zhouxy-rrookie/DOG/CAD/sefa v1.png

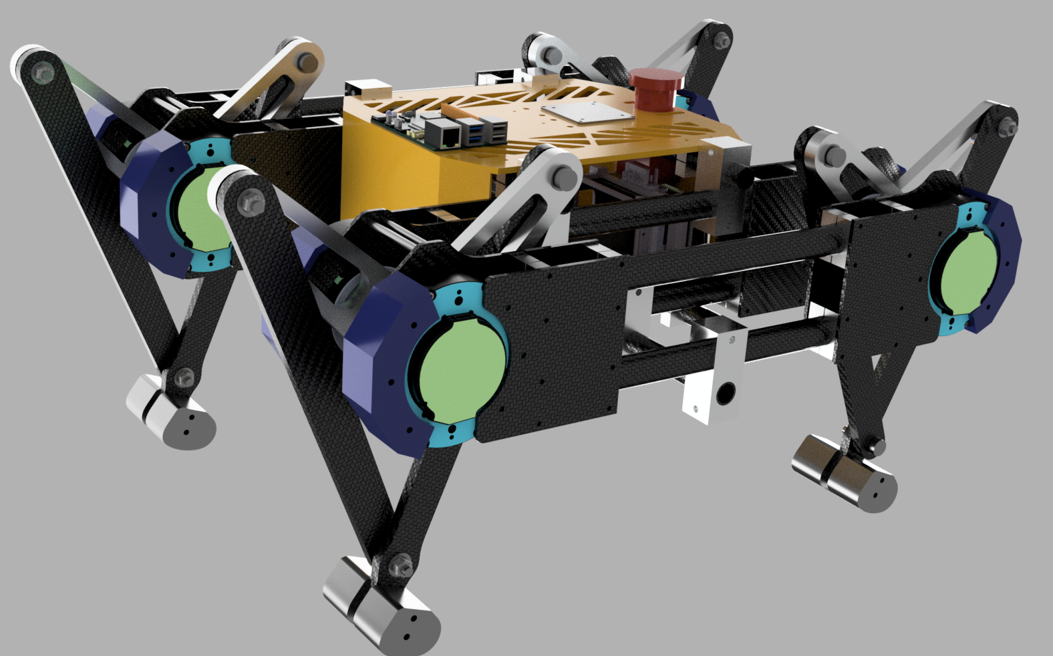
CAD/sefa v1.png
