zhouxy-rrookie/DOG/README.md

# DOG
CSU-EK Quadruped robot
VBDBE5116
