zhouxy-rrookie/DOG/readme.txt

2月19日，增加了陀螺仪和温度计的配置，cal.c开工，完成四连杆运动学正解算，正确性有待仿真考证。
