zhouxy-rrookie/DOG/doc/中南大学EK战队四足技术介绍（2026.2）.pdf

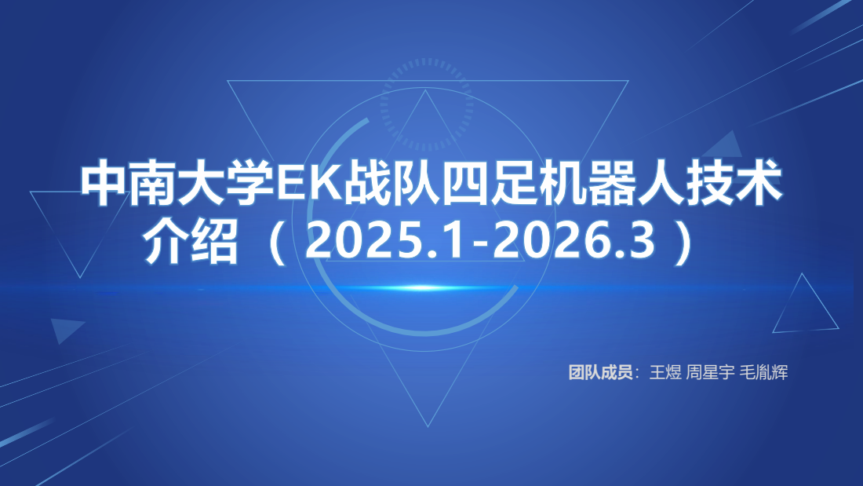
[picture p22: page 1]
中南大学EK战队四足机器人技术 介绍（ 2025.1-2026.3 ）

团队成员：王煜 周星宇 毛胤辉

# 核心竞争力

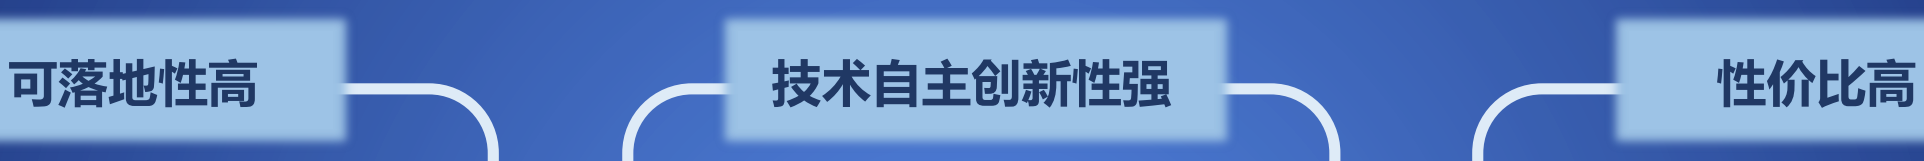
[picture p23: figure]
可落地性高; 技术自主创新性强; 性价比高
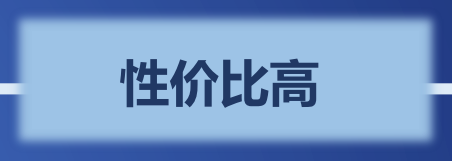
[picture p24: figure]

因产品选材、设计装配全
部流程均为有成本控制经验
的成员自主完成，相较于同
类型无人末端配送产品，本

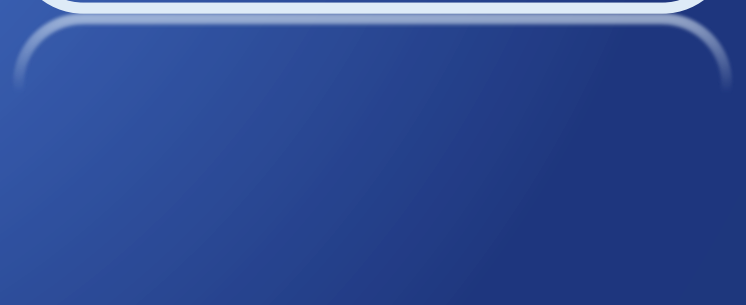
[picture p25: figure]

产品成本仅为京东无人车的
八分之一，而在复杂环境中
的执行能力更优。

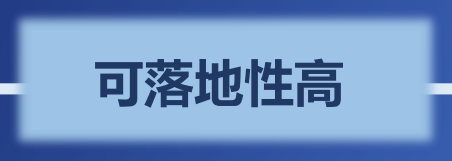
[picture p26: figure]

该项目依托中南大学工
程训练创新中心，核心成
员均来自参加大学生机器
人RoboCon竞赛的中南大

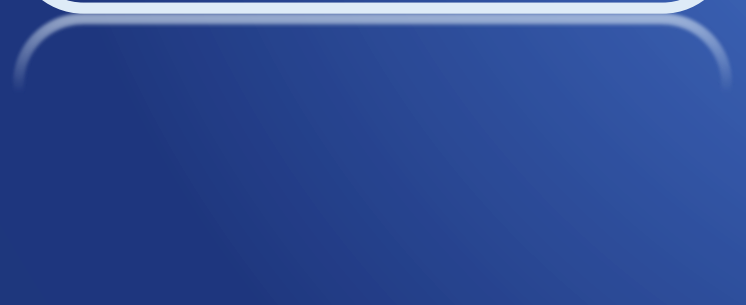
[picture p27: figure]

学EK机器人队，已做出实
物样机并在实验室测试验
证初步功能。

本项目机器狗设计制造全部
流程均由团队成员自主完成,独
立研发了动态雅可比补偿虚拟
力控算法增强运动灵活性，开

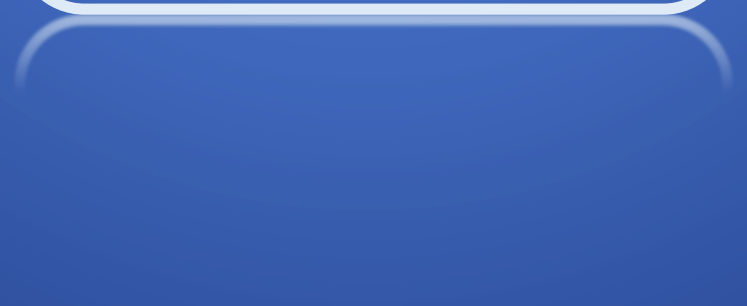
[picture p28: figure]

发行业前沿的PNLC-SLAM算
法 实 现 精 确 导 航 ， 改进 A*-
DWA算法做到高速动态避障。
项目概要 | 市场分析 | 产品介绍 | 项目成果| 未来计划

# 产品介绍

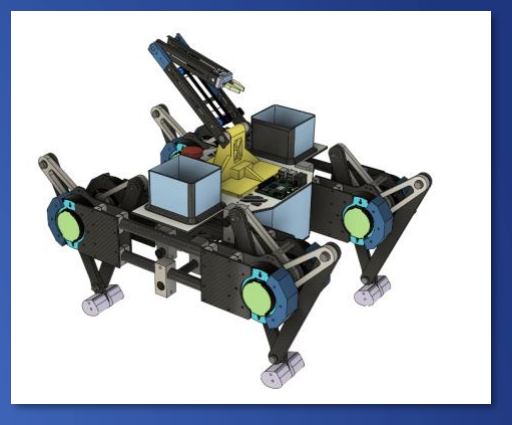
[picture p29: figure]
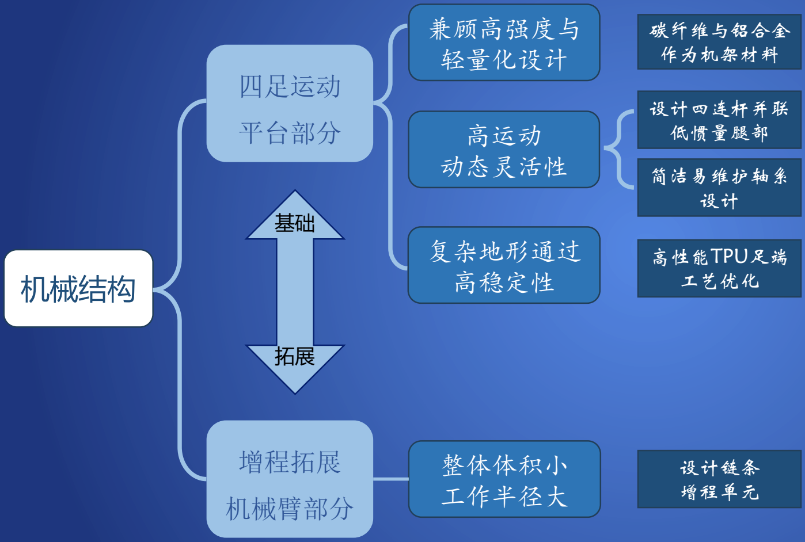
[picture p30: figure]
机械结构; 四足运动; 平台部分; 增程拓展; 机械臂部分; 兼顾高强度与 轻量化设计; 高运动 动态灵活性; 复杂地形通过 高稳定性; 整体体积小 工作半径大; 碳纤维与铝合金 作为机架材料; 设计四连杆并联 低惯量腿部; 简洁易维护轴系 设计; 高性能TPU足端 工艺优化; 设计链条 增程单元

零号机器狗示意图

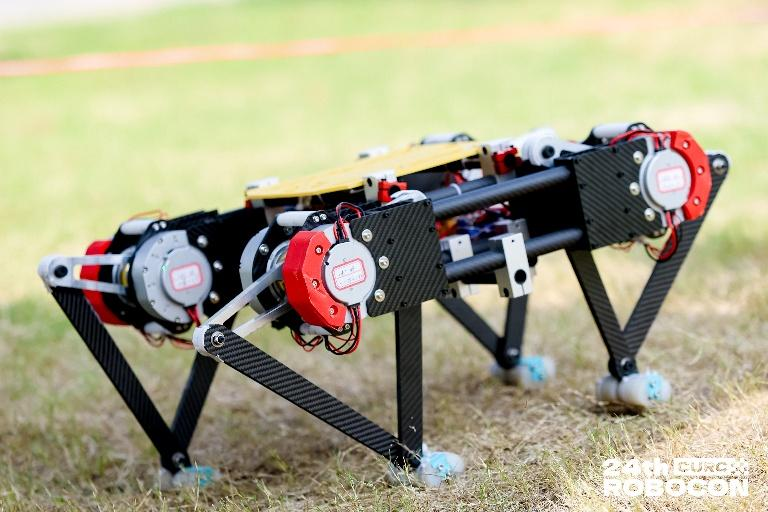
[picture p31: figure]

机器狗实物（ROBOCON越野赛）

项目概要 | 市场分析 | 产品介绍 | 项目成果| 未来计划

# 机械结构

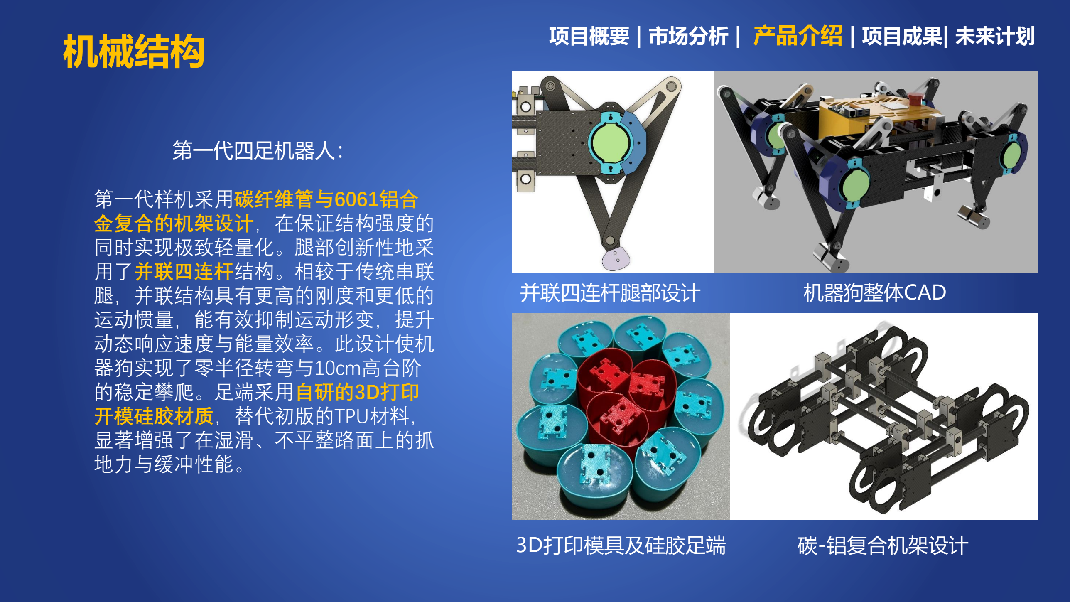
[picture p32: page 4]

第一代四足机器人：

第一代样机采用碳纤维管与6061铝合
金复合的机架设计，在保证结构强度的
同时实现极致轻量化。腿部创新性地采
用了并联四连杆结构。相较于传统串联
腿，并联结构具有更高的刚度和更低的
运动惯量，能有效抑制运动形变，提升
动态响应速度与能量效率。此设计使机
器狗实现了零半径转弯与10cm高台阶
的稳定攀爬。足端采用自研的3D打印
开模硅胶材质，替代初版的TPU材料，
显著增强了在湿滑、不平整路面上的抓
地力与缓冲性能。
3D打印模具及硅胶足端 | 碳-铝复合机架设计
并联四连杆腿部设计 | 机器狗整体CAD
项目概要 | 市场分析 | 产品介绍 | 项目成果| 未来计划

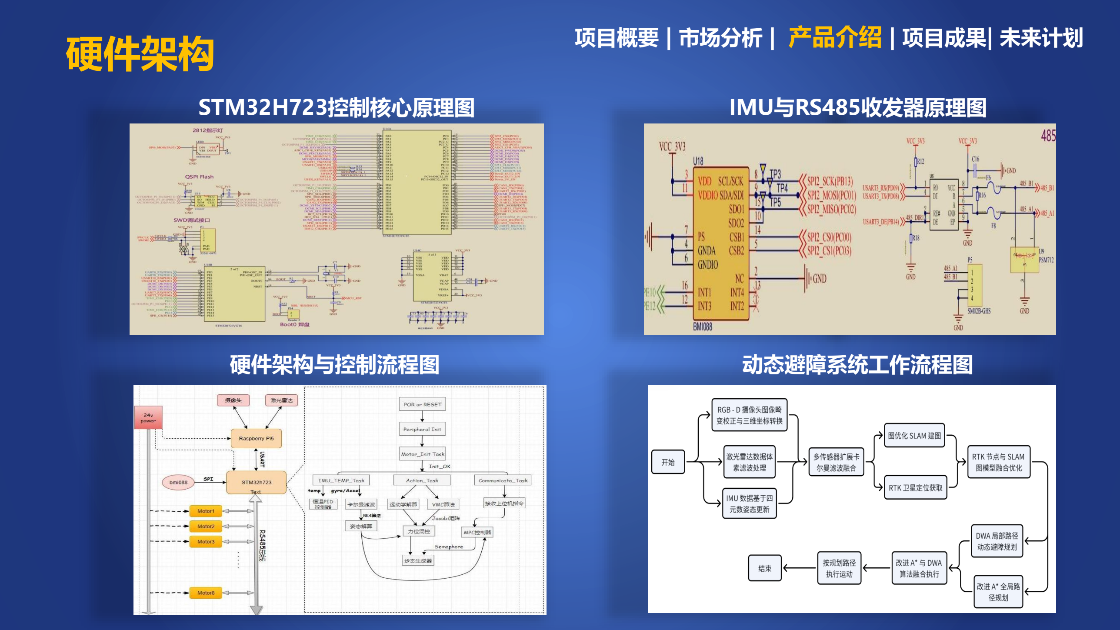
[picture p33: page 5]

STM32H723控制核心原理图 | IMU与RS485收发器原理图
硬件架构与控制流程图 | 动态避障系统工作流程图
硬件架构 | 项目概要 | 市场分析 | 产品介绍 | 项目成果| 未来计划

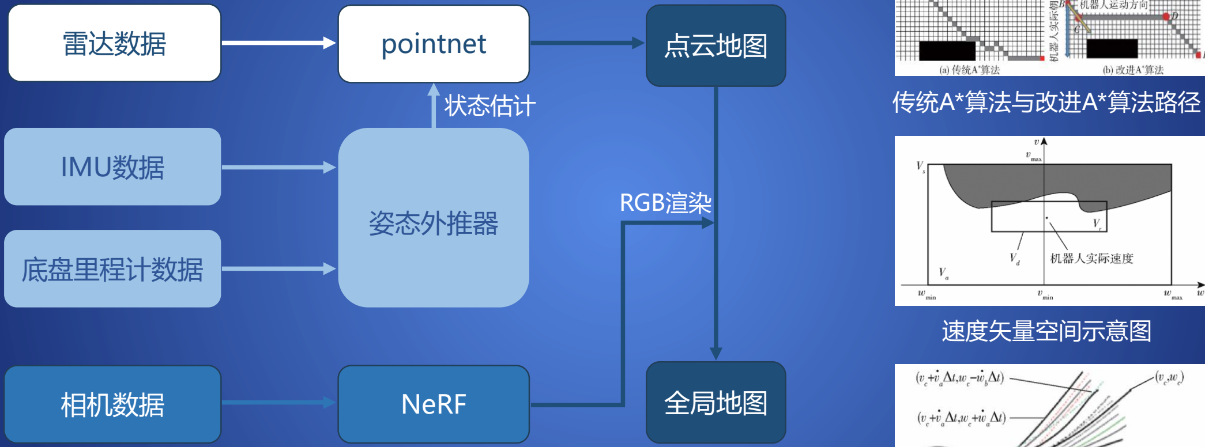
[picture p34: figure]
IMU数据; 相机数据; 姿态外推器; NeRF; 雷达数据; 底盘里程计数据; pointnet; 点云地图; 全局地图; RGB渲染; 状态估计; 传统A*算法与改进A*算法路径; 速度矢量空间示意图

## PNLC-SLAM 算法

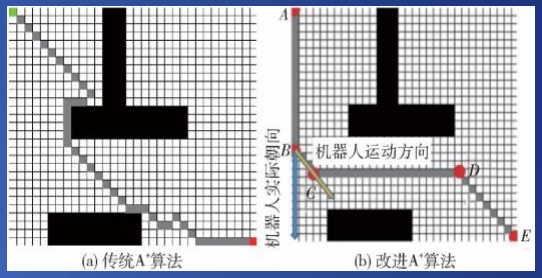
[picture p35: figure]
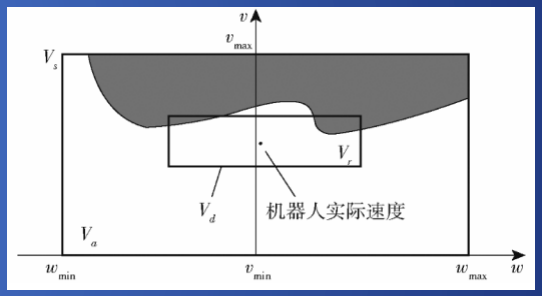
[picture p36: figure]
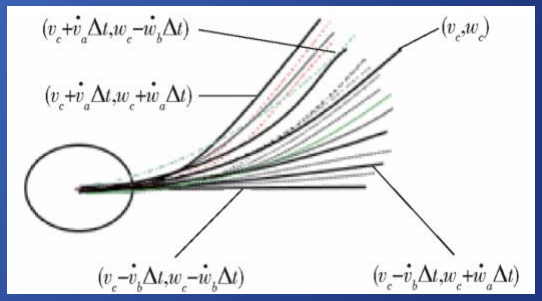
[picture p37: figure]

机器人多个轨迹生成图

控制与算法 | 项目概要 | 市场分析 | 产品介绍 | 项目成果| 未来计划

视频展示 | 项目概要 | 市场分析 | 产品介绍 | 项目成果| 未来计划

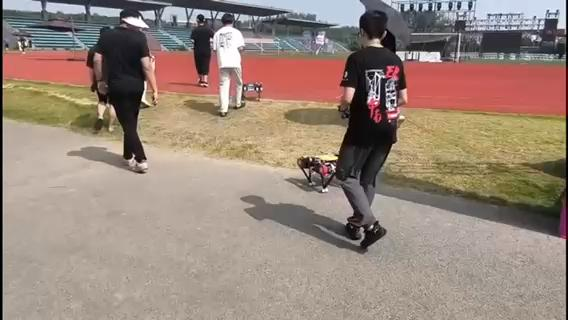
[picture p38: figure]

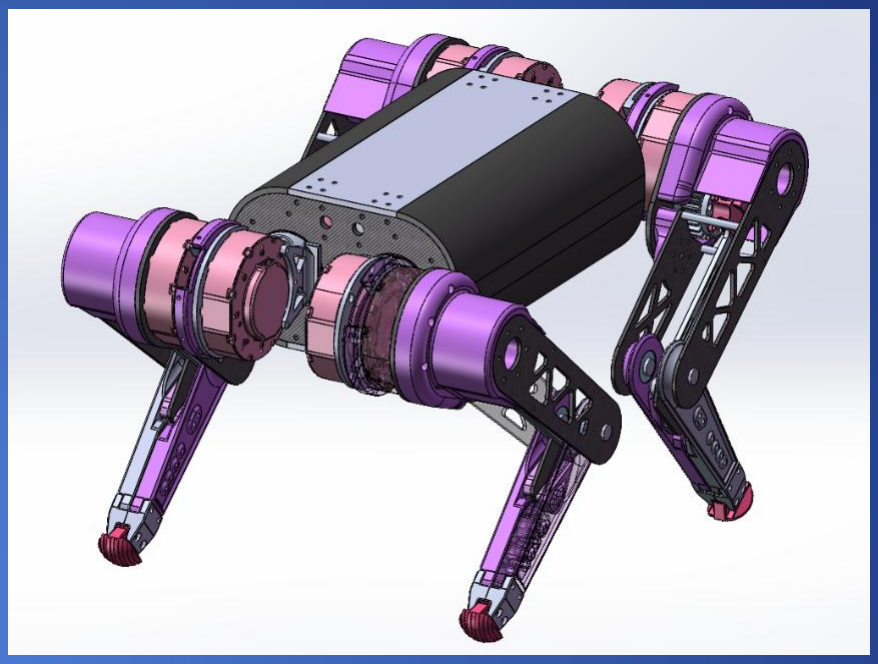
[picture p39: figure]
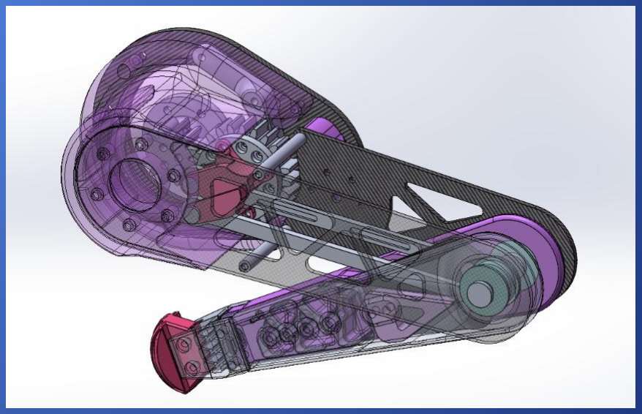
[picture p40: figure]

腿部传动及设计细节

第二代四足机器人：

在第一代基础上，第二代样机进行了突
破性升级。首先，将单腿主动自由度从
2个增加至3个，整机自由度提升至
12DOF，大幅扩展了腿部运动空间与
机身姿态调节能力。核心创新在于双连
杆轴向错位驱动技术。具体而言，calf
电机输出减速后，在腿部转动件的径向
间隔设置双连接部位，并搭配轴向错开
布置的连杆。这种设计从机械原理上彻
底规避了传统连杆机构在特定位置可能
出现的运动死点，杜绝了由此导致的运
动卡滞或失控风险，确保了腿部运动的
绝对连续性与平滑性。除此之外，第二
代四足机器人融入更多的工业设计理念，
采用多样化工程材料。

一号机器狗整体CAD

机械结构 | 项目概要 | 市场分析 | 产品介绍 | 项目成果| 未来计划

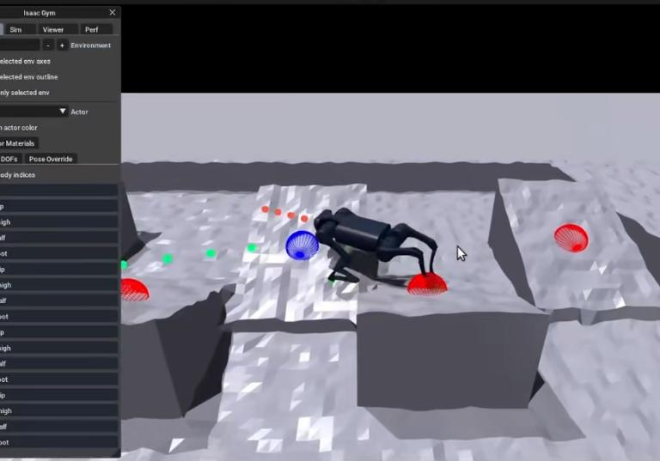
[picture p41: figure]

在Issac Gym中进行训练

# 控制与算法

第二代四足机器人：

为进一步提升在极端复杂地形和负载扰
动下的适应性与泛化能力，第二代算法
引入了强化学习。该模块定位为“低层
运动策略”，上游接收感知系统提供的
环境信息与任务指令，下游通过安全的
PD-VMC-MPC执行层输出控制量。通
过在高保真仿真环境（如Isaac Gym）
中构建老旧社区场景模型，并采用课程
学习、地形随机化、组合奖励函数设计
等方法进行训练，使策略网络能够隐式
学习复杂接触动力学、非线性扰动及步
态切换的经验。实测表明，该策略显著
增强了机器狗跨越连续台阶、碎石路、
湿滑路面时的接触鲁棒性、抗滑移能力
以及背负货物时的平衡稳定性。

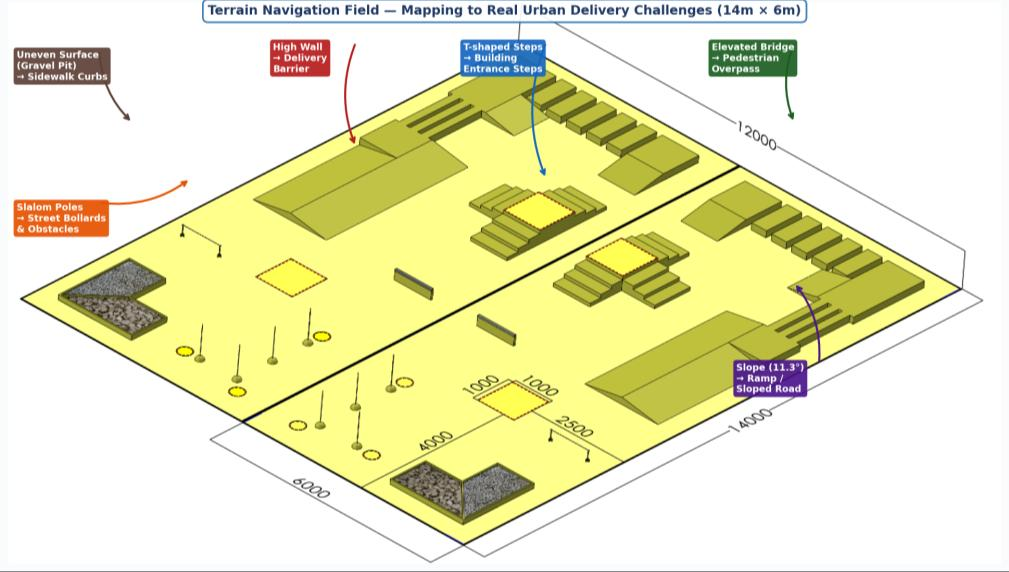
[picture p42: figure]

RC26比赛场地与老旧社区地形对应关系

项目概要 | 市场分析 | 产品介绍 | 项目成果| 未来计划

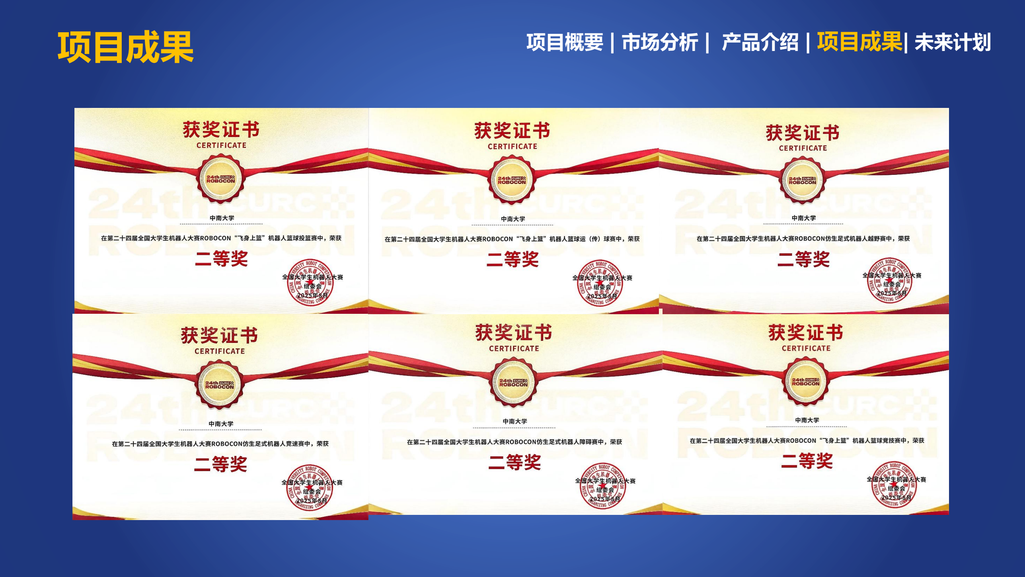
[picture p43: page 10]

项目成果 | 项目概要 | 市场分析 | 产品介绍 | 项目成果| 未来计划

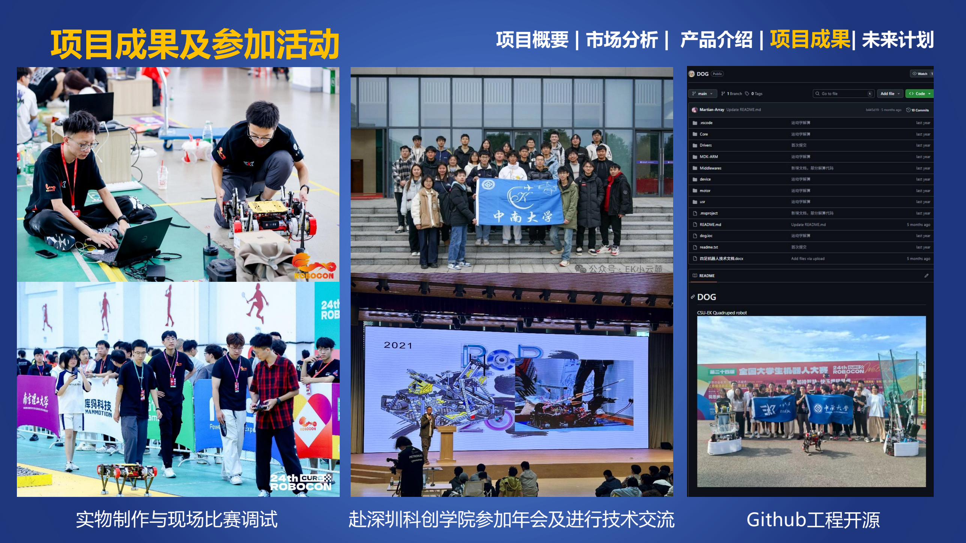
[picture p44: page 11]

项目成果及参加活动 | 项目概要 | 市场分析 | 产品介绍 | 项目成果| 未来计划
实物制作与现场比赛调试 | 赴深圳科创学院参加年会及进行技术交流 | Github工程开源

# 项目成果及参加活动

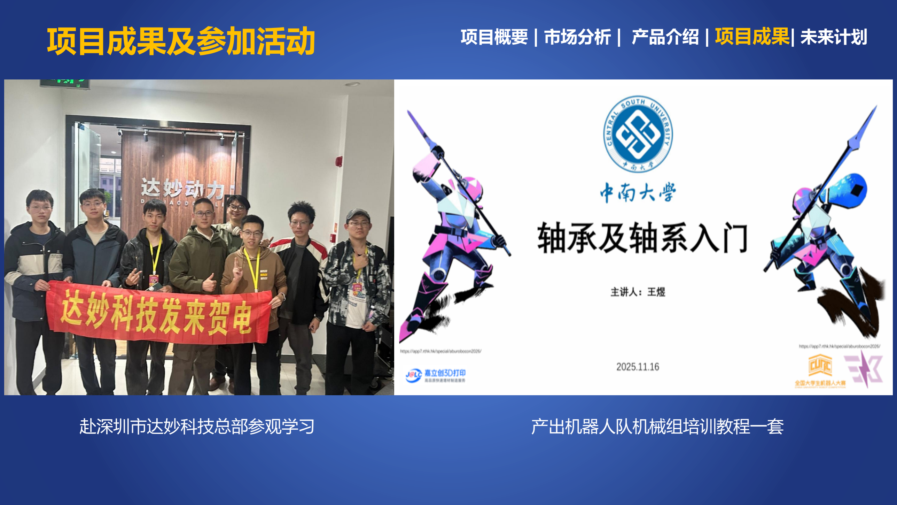
[picture p45: page 12]

项目概要 | 市场分析 | 产品介绍 | 项目成果| 未来计划

赴深圳市达妙科技总部参观学习
产出机器人队机械组培训教程一套

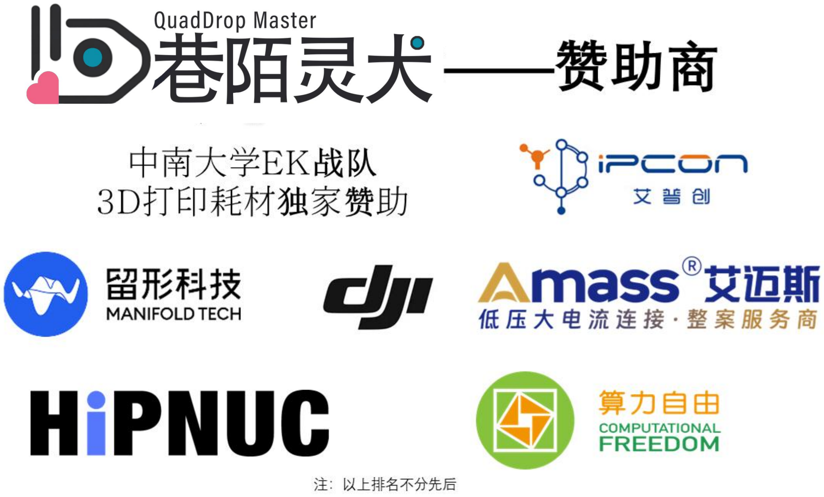
[picture p46: page 13]

# 支持单位

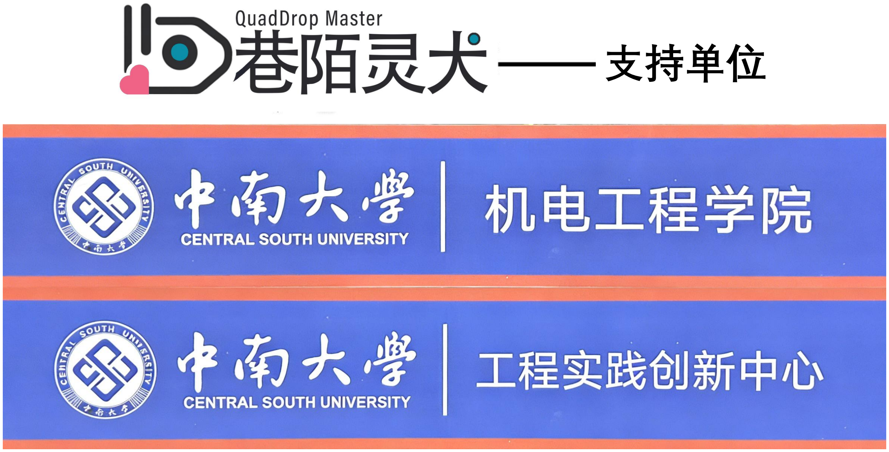
[picture p47: page 14]
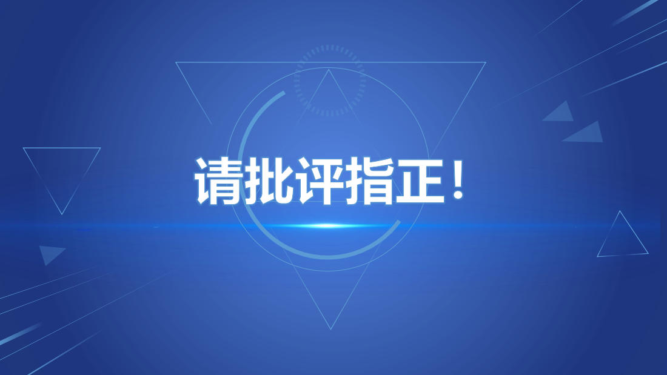
[picture p48: page 15]
请批评指正！
