zhouxy-rrookie/DOG/dog.ioc

Mcu.UserName=STM32H723VGTx
PA1.Signal=USART2_DE
PA13(JTMS/SWDIO).Signal=DEBUG_JTMS-SWDIO
PA14(JTCK/SWCLK).Signal=DEBUG_JTCK-SWCLK
PA5.Signal=SPI6_SCK
PA7.Signal=SPI6_MOSI
PB1.Signal=S_TIM3_CH4
PB11.Signal=USART3_RX
PB13.Signal=SPI2_SCK
PB14.GPIO_Label=RS485_DE1
PB14.Signal=GPIO_Output
PC0.GPIO_Label=ACC_CS
PC0.Signal=GPIO_Output
PC1.Signal=SPI2_MOSI
PC12.Signal=UART5_TX
PC13.GPIO_Label=POWER_OUT2
PC13.Signal=GPIO_Output
PC14-OSC32_IN.GPIO_Label=POWER_OUT1
PC14-OSC32_IN.Signal=GPIO_Output
PC15-OSC32_OUT.GPIO_Label=POWER_OUT5V
PC15-OSC32_OUT.Signal=GPIO_Output
PC2_C.Signal=SPI2_MISO
PC3_C.GPIO_Label=GYRO_CS
PC3_C.Signal=GPIO_Output
PD12.Signal=USART3_DE
PD2.Signal=UART5_RX
PD4.GPIO_Label=RS485_DE2
PD4.Signal=GPIO_Output
PD5.Signal=USART2_TX
PD6.Signal=USART2_RX
PD8.Signal=USART3_TX
PD9.Signal=GPXTI9
PE10.GPIO_Label=ACC_INT
PE10.Signal=GPIO_Output
PE12.GPIO_Label=GYRO_INT
PE12.Signal=GPIO_Output
PE2.Signal=USART10_RX
PE3.Signal=USART10_TX
PH0-OSC_IN.Signal=RCC_OSC_IN
PH1-OSC_OUT.Signal=RCC_OSC_OUT
