zhouxy-rrookie/DOG/Core/Inc/main.h

#define POWER_OUT2_Pin GPIO_PIN_13
#define POWER_OUT2_GPIO_Port GPIOC
#define POWER_OUT1_Pin GPIO_PIN_14
#define POWER_OUT1_GPIO_Port GPIOC
#define POWER_OUT5V_Pin GPIO_PIN_15
#define POWER_OUT5V_GPIO_Port GPIOC
#define ACC_CS_Pin GPIO_PIN_0
#define ACC_CS_GPIO_Port GPIOC
#define GYRO_CS_Pin GPIO_PIN_3
#define GYRO_CS_GPIO_Port GPIOC
#define ACC_INT_Pin GPIO_PIN_10
#define ACC_INT_GPIO_Port GPIOE
#define GYRO_INT_Pin GPIO_PIN_12
#define GYRO_INT_GPIO_Port GPIOE
#define RS485_DE1_Pin GPIO_PIN_14
#define RS485_DE1_GPIO_Port GPIOB
#define RS485_DE2_Pin GPIO_PIN_4
#define RS485_DE2_GPIO_Port GPIOD
