zhouxy-rrookie/DOG/(commit log)

2025-02-28 首次提交
2025-02-28 第二次提交
2025-03-05 新增文档，部分解算代码
2025-03-06 新增部分运动学逆解算
2025-03-29 运动学解算
